marianobustos/efm32-board/README.md

# efm32-board
efm32 happy gecko board for lqfp48 parts

#### Schematic

[Schematic in pdf](efm32-board.pdf)

board schematic

#### 3D view
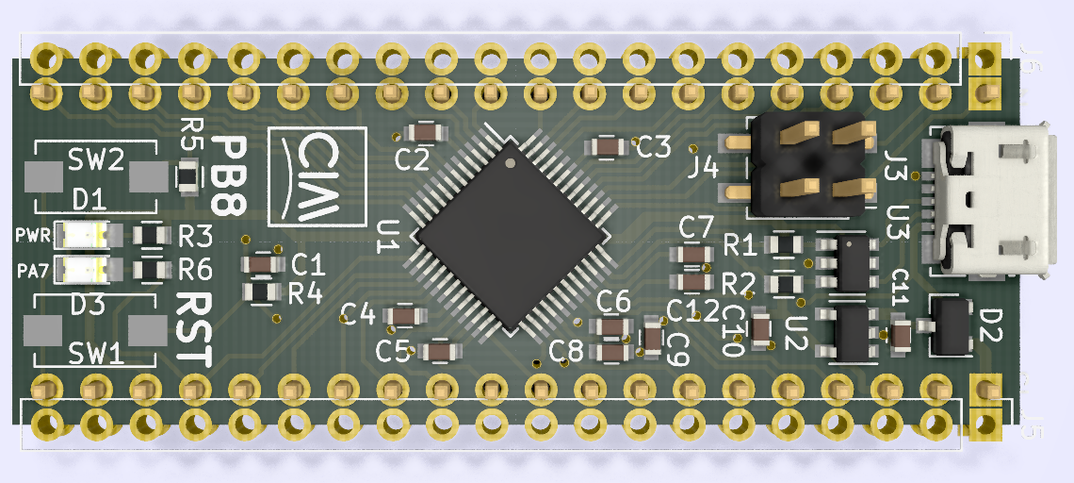
[picture p1: efm32-board.png]
boar dimage
