marianobustos/efm32-board/3DShapes/SW_SPST_EVQPE1.step

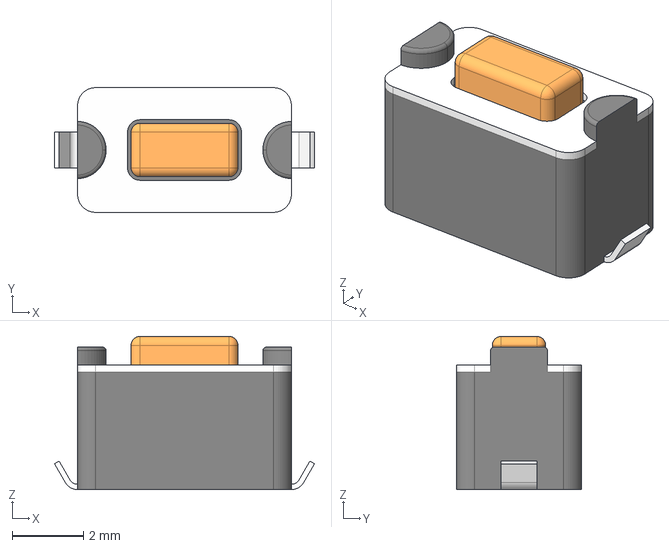
[picture p2: CAD file, 2017-10-06]
3DShapes/SW_SPST_EVQPE1.step
7.30 x 3.50 x 4.30 mm
