marianobustos/efm32-board/efm32-board.pdf

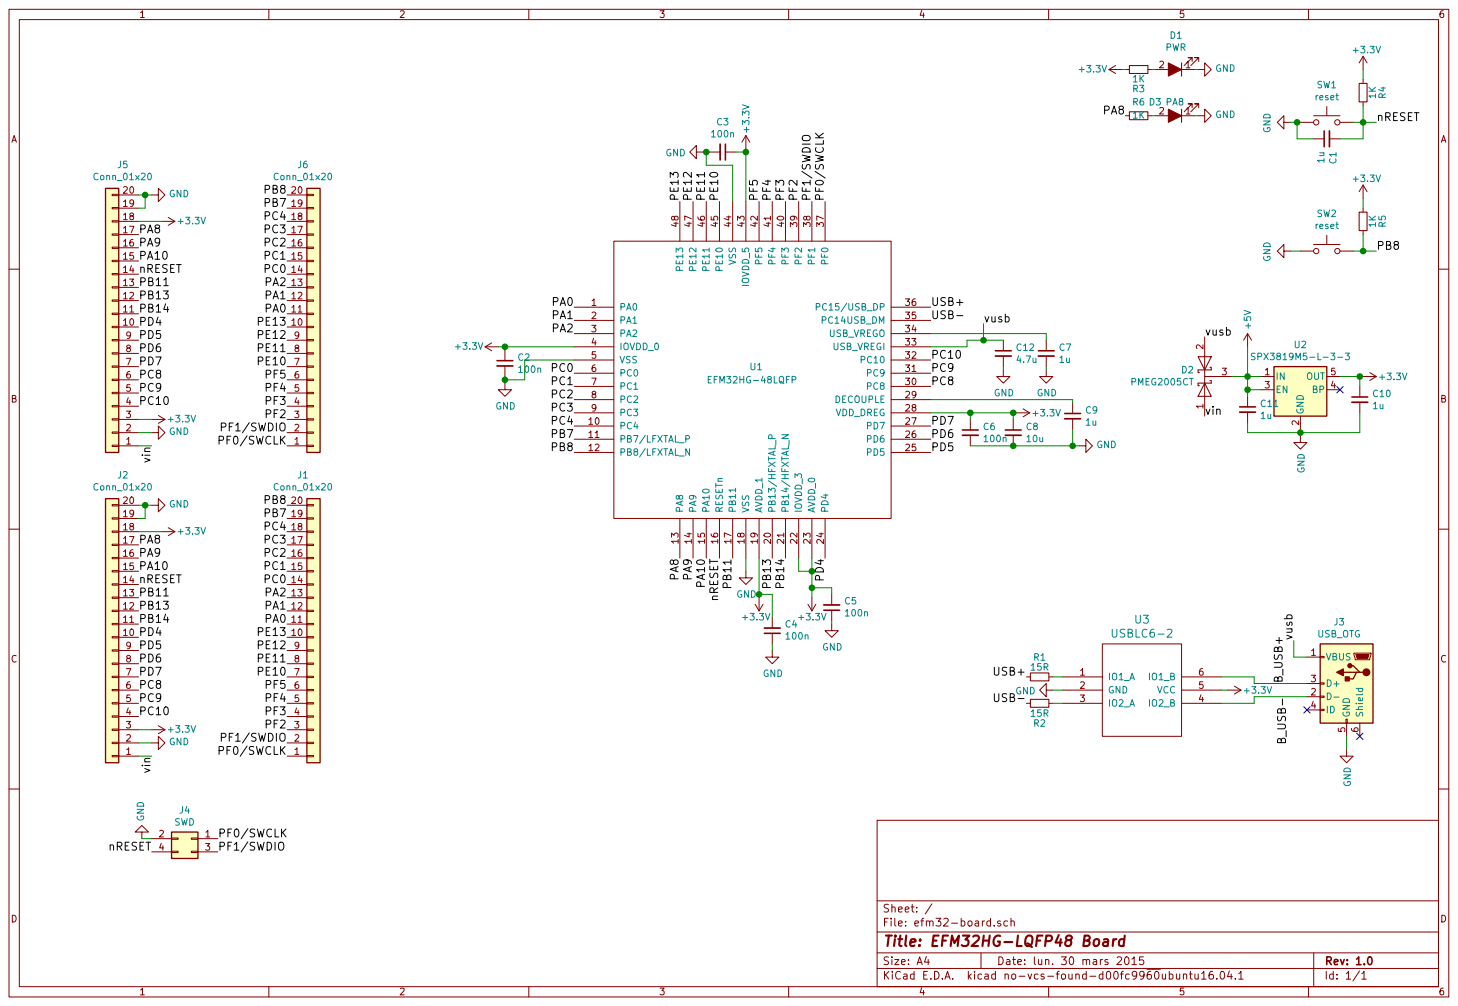
[picture p3: page 1]

File: efm32-board.sch Sheet: /
Id: 1/1 Title: EFM32HG-LQFP48 Board
