marianobustos/efm32-board/(commit log)

2017-10-03 Add +5v input diode array for split vbus and vin
    [efm32-board.kicad_pcb, efm32-board.sch]
2017-10-03 Update schematic and images
2017-10-03 Corrections and fixeds
    [efm32-board.kicad_pcb, efm32-board.sch]
2017-10-03 Add jump to pins 2-4 on J4 (SWD)
    [efm32-board.kicad_pcb, efm32-board.sch]
2017-10-03 Update schematic
2017-10-03 Change usb resistors from 22R to 15R
    [efm32-board.kicad_pcb, efm32-board.sch]
2017-10-03 Various fixes for release
    [efm32-board.kicad_pcb, efm32-board.sch]
2017-10-03 Add +3v3 on pin 18 (previous GND) for prototyping convenience
    [efm32-board.kicad_pcb, efm32-board.sch]
2017-10-03 Add copyright and logo
    [efm32-board.kicad_pcb]
2017-10-04 Add logos and copyright, export gerbers and bom
    [bom.xls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]
2017-10-04 Add dimention to PCB
    [efm32-board.kicad_pcb]
2017-10-06 Modelo 3D pulsador y ocultar designators
    Se agregan los modelos 3D de los pulsadores y se ocultan los designator
    de J1/2/5/6 de la serigrafía porque estaban fuera de la placa.
    [SW_SPST_EVQPE1.step, efm32-board.kicad_pcb]
