marianobustos/efm32-board/(notices)

Notices in the files:
efm32-board.kicad_pcb:
licenced under
BSD-3 clauses
copyright © by
Martin Ribelotta
